POETSII/a5v11-mod-01/README.md

FE1.1s-based USB hub to mount on the front of PSoC 5LP development kit board.
Takes two USBs from PSoC board, one via flex cable, converts to single robust USB.

Schematic based on design from https://github.com/rororor/a5v11-mod-01

MIT Licensed
