POETSII/a5v11-mod-01/sch/gerber/proto1panel/proto1panel_Combined_Top.png

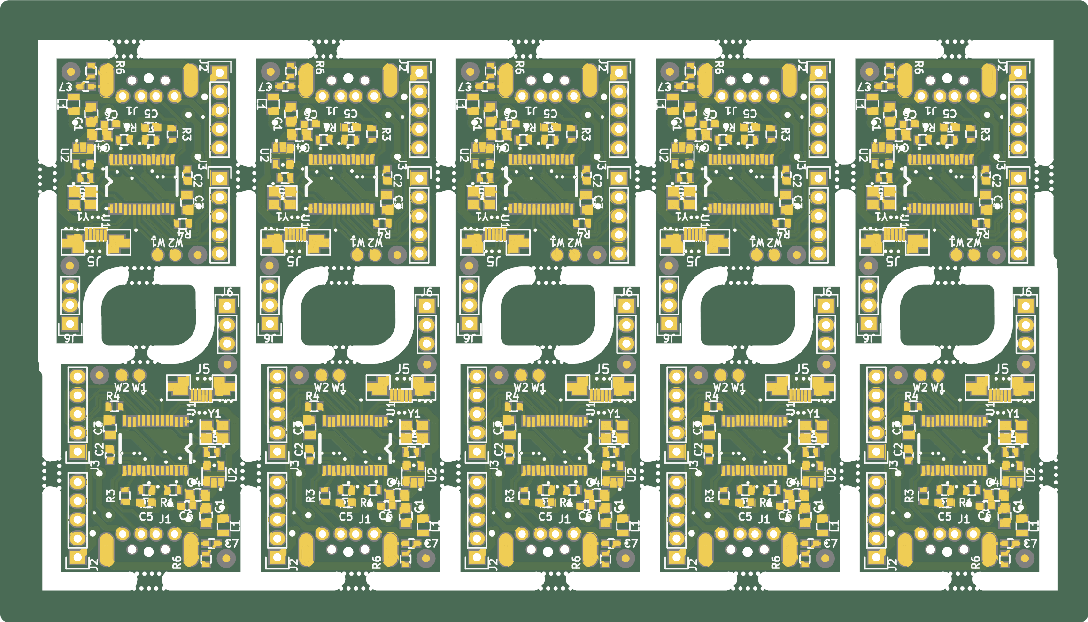
sch/gerber/proto1panel/proto1panel_Combined_Top.png
