POETSII/a5v11-mod-01/(commit log)

2018-02-28 Add outlines for attachment to a PSoC 5LP dev kit CY8KIT-059
2018-02-28 Refactoring to fit new footprint. Bring all components to upper side
    [a5v11-mod-01.kicad_pcb, a5v11-mod-01.sch]
2018-02-28 Add footprints for connectors, persuade Kicad to route through pads. USB PCB land pattern comes from https://github.com/inversepath/usbarmory which is CERN Open Hardware Licence (OHL) v1.2.
    [a5v11-mod-01.kicad_pcb, a5v11-mod-01.sch]
2018-02-28 Add a couple of headers for spare USB ports and manage to route them
    [a5v11-mod-01.kicad_pcb, a5v11-mod-01.sch]
2018-02-28 Clean up pours that have been built up from lots of tracks
    [a5v11-mod-01.kicad_pcb, a5v11-mod-01.sch]
2018-02-28 Tidy up routing, route power and ground
    [a5v11-mod-01.kicad_pcb, a5v11-mod-01.sch]
2018-03-01 Tidy up routing, route remaining power wires. Fix bugs on schematic (according to datasheet)
    [a5v11-mod-01.kicad_pcb, a5v11-mod-01.sch]
2018-03-01 Add a load switch/over current detect for all power outputs
    [a5v11-mod-01.kicad_pcb, a5v11-mod-01.sch]
2018-03-01 Tidy, add a bottom pour
    [a5v11-mod-01.kicad_pcb, a5v11-mod-01.sch]
2018-03-01 Add a placeholder for alignment pins
    [a5v11-mod-01.kicad_pcb]
2018-03-01 Swap pins of USB PCB land, since we're a female not a male. Lots of refactoring to shuffle power supply around
    [a5v11-mod-01.kicad_pcb, a5v11-mod-01.sch]
2018-03-01 Wire up FPC connector after testing it works on prototype board
    [a5v11-mod-01.kicad_pcb, a5v11-mod-01.sch]
2018-03-01 Add fiducials. Squeeze USB PCB land
    [a5v11-mod-01.kicad_pcb, a5v11-mod-01.sch]
2018-03-02 More tweaking
    [a5v11-mod-01.kicad_pcb, a5v11-mod-01.sch]
2018-03-02 Remove old gerber outputs
    [a5v11-mod-01-B.Cu.gbr, a5v11-mod-01-B.Mask.gbr, a5v11-mod-01-B.SilkS.gbr, a5v11-mod-01-Edge.Cuts.gbr, a5v11-mod-01-F.Cu.gbr, a5v11-mod-01-F.Mask.gbr, a5v11-mod-01-F.SilkS.gbr, a5v11-mod-01-drl_map.gbr]
2018-03-02 Add a couple of 100n decouplers on 1.8v and 3.3v rails
    [a5v11-mod-01.kicad_pcb, a5v11-mod-01.sch]
2018-03-03 Add measurement points so we can probe hidden USB tracks after soldering
    [a5v11-mod-01.kicad_pcb, a5v11-mod-01.sch]
2018-03-03 Fix crystal footprint, add R and C for USB shield
    [a5v11-mod-01.kicad_pcb, a5v11-mod-01.sch]
2018-03-03 Move around labels to sensible places
    [a5v11-mod-01.kicad_pcb]
2018-03-03 Label USB pads on the bottom
    [a5v11-mod-01.kicad_pcb]
2018-03-03 Tidy some vias
    [a5v11-mod-01.kicad_pcb]
2018-03-03 Rearrange so there's ground underneath chip, not 1.8v
    [a5v11-mod-01.kicad_pcb]
2018-03-03 For some reason, header was on the underside. Flip it.
    [a5v11-mod-01.kicad_pcb]
2018-03-03 Flip header and remove pours inside USB pads
    [a5v11-mod-01.kicad_pcb]
2018-03-03 Add edge routing and mouse bites, for 2.54mm router
    [a5v11-mod-01.kicad_pcb]
2018-03-03 Redo with 2mm mouse bites and edge lines
    [a5v11-mod-01.kicad_pcb]
2018-03-05 Lots of tinkering with panelization, not very successfully. Move locating header and add curve for robustness
    [a5v11-mod-01.kicad_pcb]
2018-03-05 Add a pretty SVG of the board
2018-03-05 Prototype 1 set of gerbers (unpanelized)
    [a5v11-mod-01-B.Cu.gbl, a5v11-mod-01-B.Mask.gbs, a5v11-mod-01-B.Paste.gbp, a5v11-mod-01-B.SilkS.gbo, a5v11-mod-01-Edge.Cuts.gm1, a5v11-mod-01-F.Cu.gtl, a5v11-mod-01-F.Mask.gts, a5v11-mod-01-F.Paste.gtp]
2018-03-05 Add origin mark at bottom left
    [a5v11-mod-01-B.Cu.gbl, a5v11-mod-01-B.Mask.gbs, a5v11-mod-01-B.Paste.gbp, a5v11-mod-01-B.SilkS.gbo, a5v11-mod-01-Edge.Cuts.gm1, a5v11-mod-01-F.Cu.gtl, a5v11-mod-01-F.Mask.gts, a5v11-mod-01-F.Paste.gtp]
2018-03-05 Move origin to top left
    [a5v11-mod-01-B.Cu.gbl, a5v11-mod-01-B.Mask.gbs, a5v11-mod-01-B.Paste.gbp, a5v11-mod-01-B.SilkS.gbo, a5v11-mod-01-Edge.Cuts.gm1, a5v11-mod-01-F.Cu.gtl, a5v11-mod-01-F.Mask.gts, a5v11-mod-01-F.Paste.gtp]
2018-03-05 Revert to bottom left origin, add symlink to .gko file for outline
    [a5v11-mod-01-B.Cu.gbl, a5v11-mod-01-B.Mask.gbs, a5v11-mod-01-B.Paste.gbp, a5v11-mod-01-B.SilkS.gbo, a5v11-mod-01-Edge.Cuts.gm1, a5v11-mod-01-F.Cu.gtl, a5v11-mod-01-F.Mask.gts, a5v11-mod-01-F.Paste.gtp]
2018-03-05 Add panelisation file for GerberPanelizer
    [a5v11-mod-01-Outline.gko]
2018-03-05 Remove layer alignment target from Edge Cuts (messed up panelisation edge)
    [a5v11-mod-01-B.Cu.gbl, a5v11-mod-01-B.Mask.gbs, a5v11-mod-01-B.Paste.gbp, a5v11-mod-01-B.SilkS.gbo, a5v11-mod-01-Edge.Cuts.gm1, a5v11-mod-01-F.Cu.gtl, a5v11-mod-01-F.Mask.gts, a5v11-mod-01-F.Paste.gtp]
2018-03-05 Added version number text and space to write serial number
    [a5v11-mod-01-B.Cu.gbl, a5v11-mod-01-B.Mask.gbs, a5v11-mod-01-B.Paste.gbp, a5v11-mod-01-B.SilkS.gbo, a5v11-mod-01-Edge.Cuts.gko, a5v11-mod-01-F.Cu.gtl, a5v11-mod-01-F.Mask.gts, a5v11-mod-01-F.Paste.gtp]
2018-03-05 Generate panelized Gerbers, merging drill files with GerberCombiner
    [combined.drl, combined.gbl, combined.gbo, combined.gbp, combined.gbs, combined.gko, combined.gm1, combined.gtl]
2018-03-06 Pull back flexi connector from edge of board. Respin gerbers
    [a5v11-mod-01-B.Cu.gbl, a5v11-mod-01-B.Mask.gbs, a5v11-mod-01-B.Paste.gbp, a5v11-mod-01-B.SilkS.gbo, a5v11-mod-01-Edge.Cuts.gko, a5v11-mod-01-Edge.Cuts.gm1, a5v11-mod-01-F.Cu.gtl, a5v11-mod-01-F.Mask.gts]
2018-03-06 Pull back text from outside board perimeter
    [a5v11-mod-01-B.Cu.gbl, a5v11-mod-01-B.Mask.gbs, a5v11-mod-01-B.Paste.gbp, a5v11-mod-01-B.SilkS.gbo, a5v11-mod-01-Edge.Cuts.gm1, a5v11-mod-01-F.Cu.gtl, a5v11-mod-01-F.Mask.gts, a5v11-mod-01-F.Paste.gtp]
2018-03-06 Panelize current gerbers
    [combined.drl, combined.gbl, combined.gbo, combined.gbp, combined.gbs, combined.gm1, combined.gtl, combined.gto]
2018-03-08 Move origin and board alignment target to a spare piece of board, not the corner
    [a5v11-mod-01-B.Cu.gbl, a5v11-mod-01-B.Mask.gbs, a5v11-mod-01-B.Paste.gbp, a5v11-mod-01-B.SilkS.gbo, a5v11-mod-01-Edge.Cuts.gm1, a5v11-mod-01-F.Cu.gtl, a5v11-mod-01-F.Mask.gts, a5v11-mod-01-F.Paste.gtp]
2018-03-08 Re-panelize, shuffling around due to changes in origins
    [combined.drl, combined.gbl, combined.gbo, combined.gbp, combined.gbs, combined.gko, combined.gm1, combined.gtl]
2018-03-08 Remove extraneous files which could confuse the fab
    [combined.drl, combined.gm1]
2018-05-11 Add castellations to USB connector, refactor other parts to accommodate
    [a5v11-mod-01-B.Cu.gbl, a5v11-mod-01-B.Mask.gbs, a5v11-mod-01-B.Paste.gbp, a5v11-mod-01-B.SilkS.gbo, a5v11-mod-01-Edge.Cuts.gm1, a5v11-mod-01-F.Cu.gtl, a5v11-mod-01-F.Mask.gts, a5v11-mod-01-F.Paste.gtp]
2018-05-11 Bump the revision on the silkscreen
    [a5v11-mod-01-B.Cu.gbl, a5v11-mod-01-B.Mask.gbs, a5v11-mod-01-B.Paste.gbp, a5v11-mod-01-B.SilkS.gbo, a5v11-mod-01-Edge.Cuts.gm1, a5v11-mod-01-F.Cu.gtl, a5v11-mod-01-F.Mask.gts, a5v11-mod-01-F.Paste.gtp]
2018-05-11 Add fillets to both sides to avoid castellations delaminating
    [a5v11-mod-01-B.Cu.gbl, a5v11-mod-01-B.Mask.gbs, a5v11-mod-01-B.Paste.gbp, a5v11-mod-01-B.SilkS.gbo, a5v11-mod-01-Edge.Cuts.gm1, a5v11-mod-01-F.Cu.gtl, a5v11-mod-01-F.Mask.gts, a5v11-mod-01-F.Paste.gtp]
2018-05-15 Add vias on USB pads with mask keepouts, to aid thermal conductivity when soldering
    [a5v11-mod-01.kicad_pcb]
2018-05-18 Add gerbers for v2 unpanelized
    [a5v11-mod-01-B.Cu.gbl, a5v11-mod-01-B.Mask.gbs, a5v11-mod-01-B.Paste.gbp, a5v11-mod-01-B.SilkS.gbo, a5v11-mod-01-Edge.Cuts.gm1, a5v11-mod-01-F.Cu.gtl, a5v11-mod-01-F.Mask.gts, a5v11-mod-01-F.Paste.gtp]
2018-05-18 Panelize proto2
    [combined.drl, combined.gbl, combined.gbo, combined.gbp, combined.gbr, combined.gbs, combined.gko, combined.gm1]
2019-05-29 Updaet FE1.1 footprint
    [a5v11-mod-01-2019-05-29-11-52-20.sch, a5v11-mod-01.kicad_pcb, a5v11-mod-01.sch]
2019-05-29 Tiny hub board gerbers
    [a5v11-mod-01-B_Cu.gbl, a5v11-mod-01-B_Mask.gbs, a5v11-mod-01-B_Paste.gbp, a5v11-mod-01-B_SilkS.gbo, a5v11-mod-01-Edge_Cuts.gm1, a5v11-mod-01-F_Cu.gtl, a5v11-mod-01-F_Mask.gts, a5v11-mod-01-F_Paste.gtp]
